saratatianatorres-ops/Escalador/docs/img/nariz_v2.png

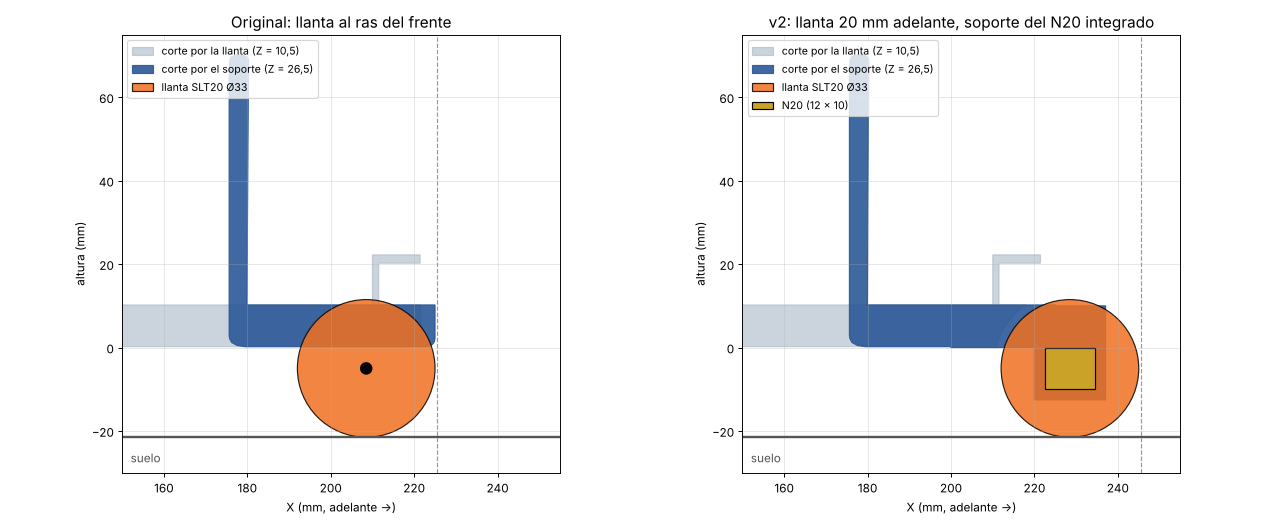
docs/img/nariz_v2.png
