saratatianatorres-ops/Escalador/hardware/esquematico.jpg

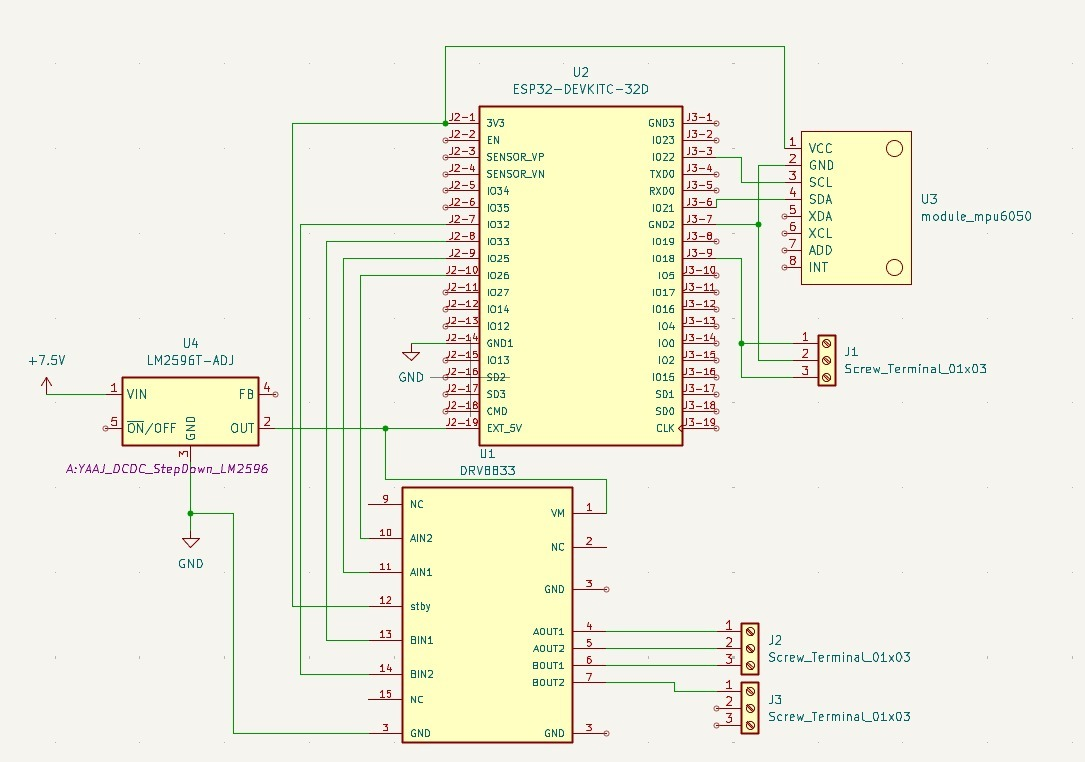
hardware/esquematico.jpg
