saratatianatorres-ops/Escalador/hardware/pcb_cobre.jpg

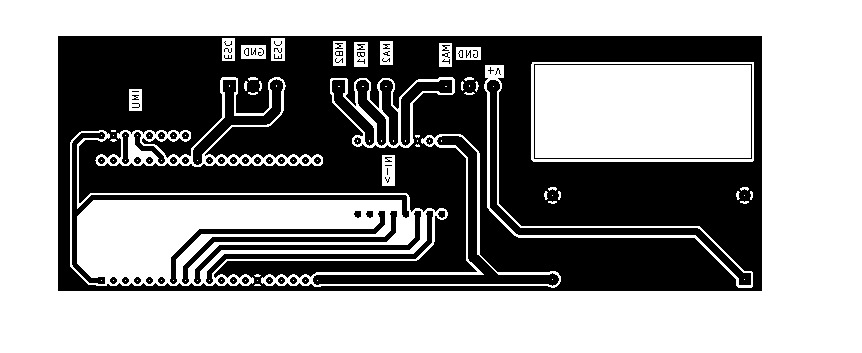
hardware/pcb_cobre.jpg
