saratatianatorres-ops/Escalador/ros2_ws/src/robot_trepador_description/meshes/base_delantera.stl

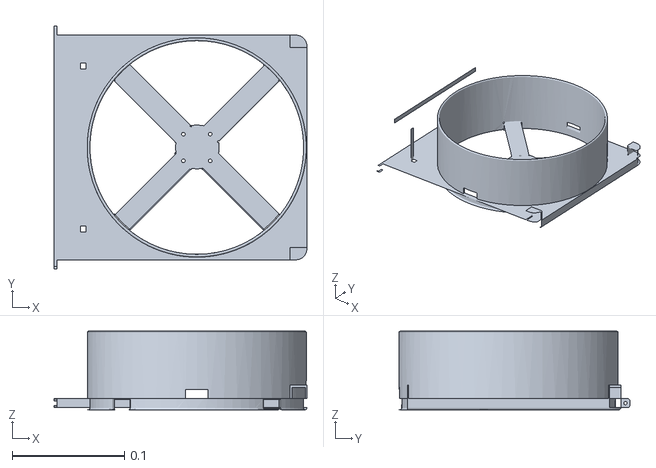
[picture p7: CAD file, 2026-11-04]
ros2_ws/src/robot_trepador_description/meshes/base_delantera.stl
0.225 x 0.216 x 0.07
