saratatianatorres-ops/Escalador/hardware/cad/Base_1_v2.STL

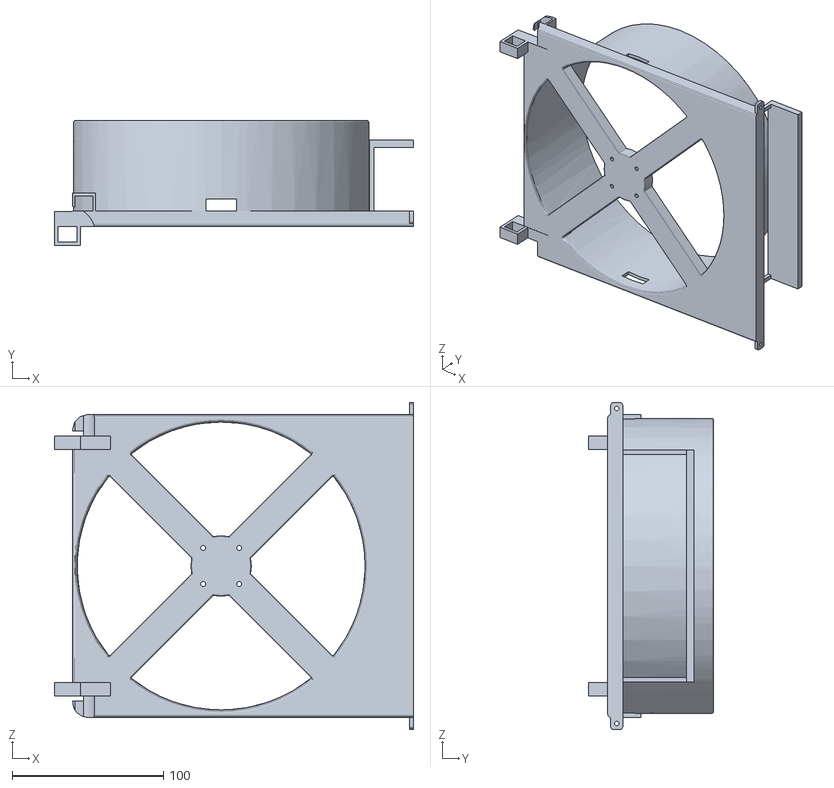
[picture p8: CAD file, 2026-11-04]
hardware/cad/Base_1_v2.STL
237.1 x 82.8 x 216.0
