saratatianatorres-ops/Escalador/ros2_ws/src/robot_trepador_description/meshes/soporte_motor_trasero.stl

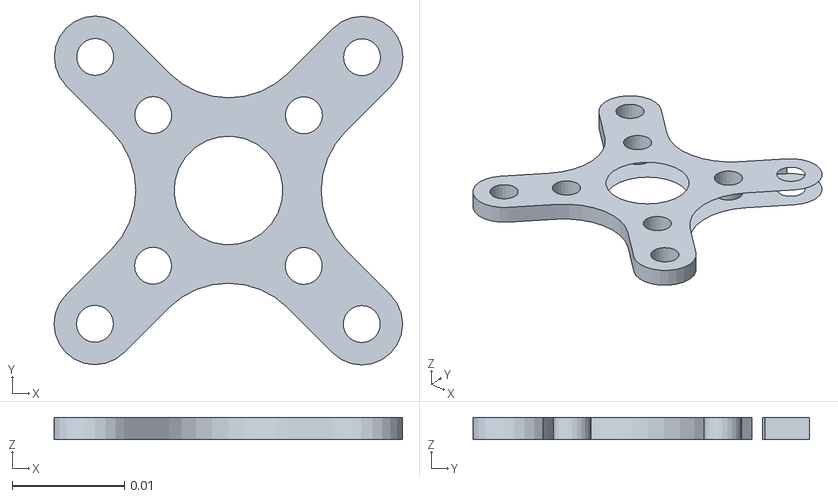
[picture p9: CAD file, 2026-11-04]
ros2_ws/src/robot_trepador_description/meshes/soporte_motor_trasero.stl
0.0311 x 0.0311 x 0.002
