saratatianatorres-ops/Escalador/ros2_ws/src/robot_trepador_description/meshes/llanta_der.stl

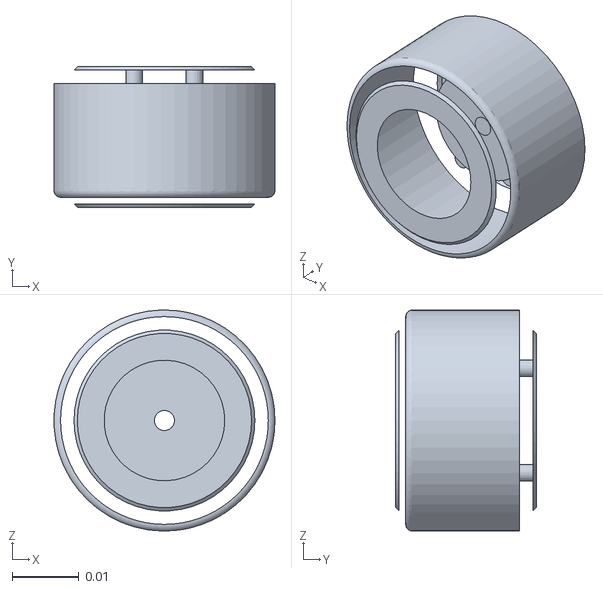
[picture p10: CAD file, 2026-11-04]
ros2_ws/src/robot_trepador_description/meshes/llanta_der.stl
0.033 x 0.021 x 0.033
