saratatianatorres-ops/Escalador/ros2_ws/src/robot_trepador_description/meshes/a2217_delantero.stl

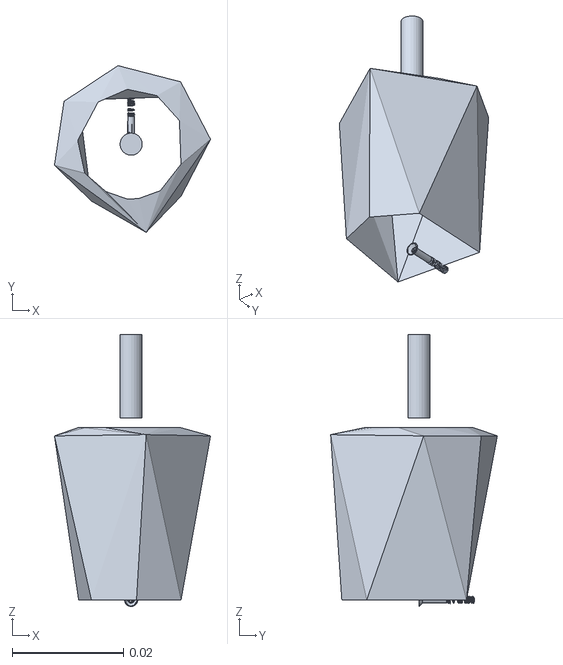
[picture p11: CAD file, 2026-11-04]
ros2_ws/src/robot_trepador_description/meshes/a2217_delantero.stl
0.0281 x 0.03 x 0.049
