saratatianatorres-ops/Escalador/hardware/cad/Base_2.STL

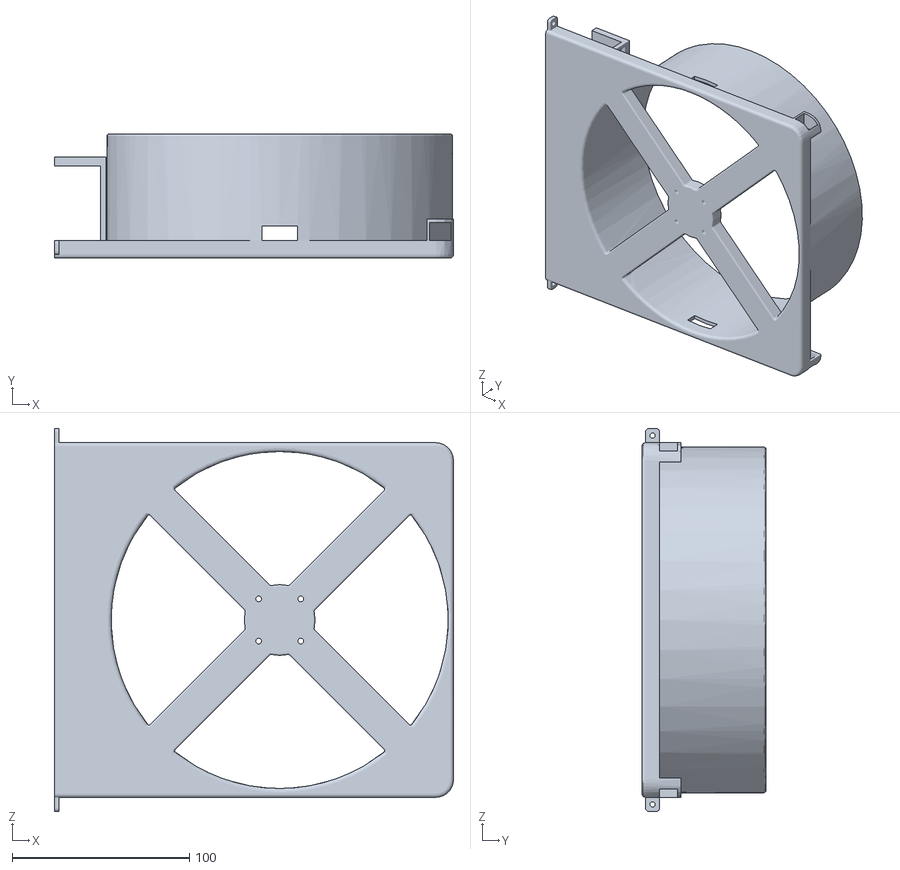
[picture p12: CAD file, 2026-11-03, an earlier design]
hardware/cad/Base_2.STL
225.0 x 70.0 x 216.0
