saratatianatorres-ops/Escalador/hardware/cad/Diseno_2.SLDASM

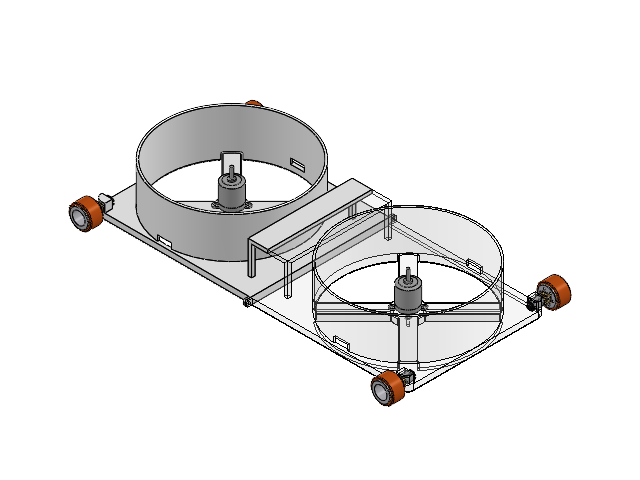
[picture p13: CAD file, 2026-11-04]
hardware/cad/Diseno_2.SLDASM
Base 2 x 2
Agarre_motor x 2
motor xd x 2
M1.4 10mm half thread.step x 8
Gearbox Casing.step x 4
15T.step x 4
9T 21T.step x 4
10T 34T.step x 4
15T 37T.step x 4
8T 33T.step x 4
27T.step x 4
Motor.step x 4
Shaft.step x 4
rin.step x 4
banda.step x 4
