saratatianatorres-ops/Escalador/(list of files, cad)

Other CAD files:
hardware/cad/Base_2_v2.STL
ros2_ws/src/robot_trepador_description/meshes/llanta_izq.stl
ros2_ws/src/robot_trepador_description/meshes/base_trasera.stl
ros2_ws/src/robot_trepador_description/meshes/a2217_trasero.stl
ros2_ws/src/robot_trepador_description/meshes/soporte_motor_delantero.stl
