saratatianatorres-ops/Escalador/firmware/robot_receptor/src/config.h

#pragma once
#include <Arduino.h>

// ============================================================
//  CONFIGURACIÓN GENERAL DEL ROBOT (todo lo ajustable está aquí)
// ============================================================

// ---------------- ESP-NOW ----------------
// Canal WiFi: debe ser el MISMO en el robot y en la ESP puente (PC).
#define CANAL_ESPNOW 1

// MAC de la ESP puente (la conectada al PC).
// Si la dejas toda en 0xFF, el robot la aprende sola con el primer
// paquete válido que reciba y desde ahí solo acepta a esa ESP.
static const uint8_t MAC_PUENTE[6] = {0xFF, 0xFF, 0xFF, 0xFF, 0xFF, 0xFF};

// Primer byte de cada paquete ESP-NOW (filtra paquetes ajenos).
#define CAB_ROBOT_A_PUENTE 0xA1
#define CAB_PUENTE_A_ROBOT 0xA2

// ---------------- Pines ----------------
#define PIN_ESC   18   // señal de los dos ESC (en paralelo)
#define PIN_AIN1  25   // DRV8833 motor A (izquierdo) - igual que hardware/esquematico.jpg
#define PIN_AIN2  26
#define PIN_BIN1  33   // DRV8833 motor B (derecho)
#define PIN_BIN2  32
#define PIN_SDA   21   // MPU6050
#define PIN_SCL   22

// ---------------- ESC (hélices) ----------------
#define ESC_APAGADO             1000   // us
#define ESC_MIN                 1100   // us
// LÍMITE DE SEGURIDAD: por encima de 1700 us los A2217 pasan de ~23-25 A y se
// pueden quemar. El robot recorta cualquier orden mayor, venga de donde venga.
#define ESC_MAX                 1700   // us
#define ESC_PASO_RAMPA          20     // us por paso
#define ESC_INTERVALO_RAMPA_MS  200    // ms entre pasos
#define ESC_TIEMPO_ARMADO_MS    3000   // 1000 us al arrancar para armar
#define ESC_TIMEOUT_MS          2000   // sin órdenes de ESC -> apagar

// ---------------- Motorreductores (DRV8833) ----------------
#define MOTOR_PWM_FREQ          20000  // Hz (fuera del rango audible)
#define MOTOR_PWM_BITS          10
#define MOTOR_PWM_MAX           1023
#define MOTOR_PWM_MIN_ARRANQUE  300    // duty mínimo para que el N20 se mueva
#define MOTOR_IZQ_INVERTIDO     false  // cambia si un lado gira al revés
#define MOTOR_DER_INVERTIDO     false
#define MOTORES_TIMEOUT_MS      500    // sin órdenes de ruedas -> parar

// Conversión de /cmd_vel (lazo abierto, sin encoders)
#define V_MAX_MS     0.30f   // velocidad aprox. del robot con PWM al 100 %
#define ANCHO_VIA_M  0.239f  // distancia entre centros de las llantas izquierda y derecha (Diseño 2.SLDASM)

// ---------------- IMU (MPU6050) ----------------
#define IMU_FREQ_HZ    200   // lectura + filtro de orientación
#define IMU_PUB_HZ     50    // publicación de /robot/imu
#define ESTADO_PUB_HZ  5     // publicación de /robot/estado
#define MAHONY_KP      1.0f
#define MAHONY_KI      0.0f
#define IMU_FRAME_ID   "imu_link"

// ---------------- micro-ROS ----------------
#define NOMBRE_NODO      "robot_trepador"
#define ESPACIO_NOMBRES  "robot"   // tópicos quedan como /robot/...

// ---------------- Batería ----------------
// Divisor de tensión:  + batería -> R1 -> PIN_BATERIA -> R2 -> GND  (+ 100 nF del pin a GND)
// La tensión en el pin no debe pasar de ~3,1 V con la batería llena.
//   2S (8,4 V):  R1 = 100k, R2 = 33k  -> 2,08 V
//   3S (12,6 V): R1 = 100k, R2 = 22k  -> 2,27 V
#define PIN_BATERIA          34        // ADC1, solo entrada (el ADC2 no funciona con ESP-NOW)
#define BAT_R1_OHM           100000.0f
#define BAT_R2_OHM           22000.0f   // 3S: 12,6 V -> 2,27 V en el pin
#define BAT_CELDAS           3         // 3S (11,1 V nominal), como la batería del robot
#define BAT_CALIBRACION      1.00f     // multímetro / valor que muestra la interfaz
#define BAT_V_CELDA_BAJA     3.50f     // aviso amarillo
#define BAT_V_CELDA_CRITICA  3.30f     // aviso rojo: bajar el robot cuanto antes
#define BAT_FREQ_HZ          10
