saratatianatorres-ops/Escalador/(commit log)

2026-11-03 Proyecto inicial: robot trepador (firmware ESP32 + interfaz ROS 2)
    Claude-Session: https://claude.ai/code/session_01F78pDj73k8A9SHdTPYAsF4
2026-11-03 Simulación en Gazebo Harmonic y visualización en RViz
    - robot_trepador_description: URDF (xacro) con chasis, 4 ruedas, 2 hélices e IMU;
    nodo odometria_imu para ver el robot real en RViz (rviz:=true en robot.launch.py)
    - robot_trepador_gazebo: habitación con suelo, pared y techo, puente ros_gz,
    y firmware_simulado que reproduce el ESP32 para que la interfaz funcione igual
    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
    [habitacion.sdf, robot_trepador.urdf.xacro]
2026-11-03 Organización tipo Carro_trepador: hardware/, docs/ y scripts/
    - hardware/: esquemático, PCB, pines, diagrama de bloques, lista de materiales
    y puntos a revisar (IO0 en J1, 5 V compartidos, un pin por ESC, batería)
    - docs/: arquitectura con grafo de nodos y tópicos, firmware, física de las
    transiciones, simulación e instalación en VirtualBox
    - scripts/instalar_dependencias.sh
    - Firmware: AIN1=IO25 y AIN2=IO26, como en el esquemático
    - Modelo: 4 N20 (uno por rueda) en vez de correa
    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
    [robot_trepador.urdf.xacro]
2026-11-03 Estado de la batería en la interfaz
    - Firmware: módulo bateria (divisor en IO34, % por celda, avisos con histéresis),
    campo "bat" en /robot/estado
    - Interfaz: panel de batería con barra, voltaje y avisos en la barra de estado
    - Simulación: batería que se descarga según el acelerador
    - Docs: cómo agregar el divisor, calibración y formato del JSON
    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
2026-11-03 Tope del ESC en 1700 us (~23-25 A por A2217)
    - Firmware: ESC_MAX = 1700; cualquier orden mayor se recorta en el robot
    - Interfaz: botón + limitado a 1700 aunque se pida más con esc_max
    - Simulación: mismo tope; empuje y corriente referidos a 1700 us;
    resistencia interna de la batería como parámetro (10 mOhm/celda)
    - Docs: el requisito de empuje pasa a medirse a 1700 us
    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
2026-11-03 URDF con el chasis real (dos bases) y llantas JSumo SLT20
    - Mallas base_delantera/base_trasera generadas de hardware/cad/Base_2.STL
    (la trasera en espejo), unidas por las repisas: 450 x 216 x 70 mm
    - 4 llantas Ø33 x 21 mm en las esquinas exteriores, vía 195 mm
    - Un A2217 por ducto (centros a ±127 mm); colisiones simples para Gazebo
    - Inercia y centro de masa calculados de la malla; masas estimadas
    - ANCHO_VIA_M = 0,195 y radio 16,5 mm en firmware, sim y odometría
    - Vista 3D de la interfaz con las proporciones nuevas
    - Docs: tabla de medidas, imagen del modelo, aviso en la física
    Claude-Session: https://claude.ai/code/session_01F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
    [Base_2.STL, base_delantera.stl, base_trasera.stl, robot_trepador.urdf.xacro]
2026-11-03 Instalador compatible con Ubuntu 22.04 + ROS 2 Humble
    - Detecta jazzy o humble; en Humble instala Gazebo Harmonic y
    ros-humble-ros-gzharmonic desde packages.osrfoundation.org
    - Ajusta board_microros_distro del firmware a la distro del PC
    - Docs: micro_ros_setup con la rama de la distro instalada
    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
2026-11-03 Instalador: compilar sin --symlink-install
    Con algunas versiones de setuptools falla con 'option --editable not
    recognized'. Probado en ROS 2 Humble y Jazzy.
    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
2026-11-03 Arreglo: argumentos numéricos del launch sin decimales cerraban el firmware simulado
    bat_mah:=5000 llegaba como entero y el nodo esperaba decimal. Ahora los
    argumentos se convierten con ParameterValue. Docs: probar en el techo.
    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
2026-11-04 Base v2 con nariz: llantas 20 mm adelante y soporte del N20 integrado
    - hardware/cad/Base_2_v2.STL y Base_1_v2.STL (generadas con herramientas/cad/base_v2.py)
    - Estudio en MuJoCo con el robot real (herramientas/fisica_mujoco/nariz.py):
    con la llanta al ras no sube; desde 10 mm pasa del suelo a la pared;
    con un pin por ESC es robusto a fricción 0,8 y N20 de 0,1 N·m
    - URDF: pesos medidos (1,32 kg), N20 como piezas fijas, colisión de los soportes
    - Simulación: empuje real 8,9 N a 1700 us que cae con el voltaje, batería 3S
    - Firmware: divisor de batería para 3S (100k/22k)
    - Docs: lista de materiales con pesos, física, simulación, hardware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
    [Base_1_v2.STL, Base_2_v2.STL, base_delantera.stl, base_trasera.stl, robot_trepador.urdf.xacro]
2026-11-04 Gazebo: luz ambiente y de relleno en la habitación
    Sin luz ambiente, las caras que no miraban al sol se veían negras
    (chasis y llantas parecían huecas).
    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
    [habitacion.sdf]
2026-11-04 Masa del robot: bases 2 x 220 g + 785 g del resto = 1225 g
    URDF, estudio de MuJoCo y docs con el peor caso que da el equipo.
    Empuje/peso a 1700 us: 1,48. Las conclusiones de la nariz no cambian.
    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
    [robot_trepador.urdf.xacro]
2026-11-04 Gazebo: el robot pasa del suelo a la pared
    - Mundo con motor de física Bullet (Featherstone): con DART la rueda que
    toca suelo y pared a la vez giraba en falso y nunca subía
    - Firmware simulado: reparto:=auto (por defecto) apaga la hélice delantera
    mientras la IMU ve el robot en el suelo; reparto:=igual = ESC en paralelo
    - Suelo más grueso para que el robot no lo atraviese si cae
    - Docs: resultados (suelo→pared ✔, pared→techo ✘ por empuje, giro lento por
    la geometría) e imagen de la subida
    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
    [habitacion.sdf]
2026-11-04 Gazebo: sin sombras
    En tarjetas de video débiles o con gráficos por software, las sombras
    dibujaban bloques negros sueltos y partes del robot en negro.
    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
    [habitacion.sdf]
2026-11-04 URDF desde el ensamble de SolidWorks (Diseño 2)
    - hardware/cad/Diseno_2.SLDASM y herramientas/cad/solidworks/: las mallas de
    la base, el soporte del motor, el A2217 y la llanta se extrajeron de la
    geometría de visualización del ensamble, con las posiciones de cada pieza
    - URDF: llantas por fuera de la placa (vía 239 mm, ejes a ±217,5 mm, eje 15 mm
    sobre la placa), N20 sobre el borde, A2217 sobre su soporte, placa a 1,5 mm
    del suelo; argumento rueda_x
    - Simulación: con los ejes del ensamble la cola de la placa toca el suelo a
    ~18° y no sube; por defecto rueda_x:=0.225 (7,5 mm más afuera), que sí sube
    - ANCHO_VIA_M = 0,239 en firmware, simulación y odometría
    - Docs e imág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
    [Diseno_2.SLDASM, a2217_delantero.stl, a2217_trasero.stl, base_delantera.stl, base_trasera.stl, llanta_der.stl, llanta_izq.stl, robot_trepador.urdf.xacro]
